radioman82/Allwellenreceiver/enclosure/radio_enclosure.stl

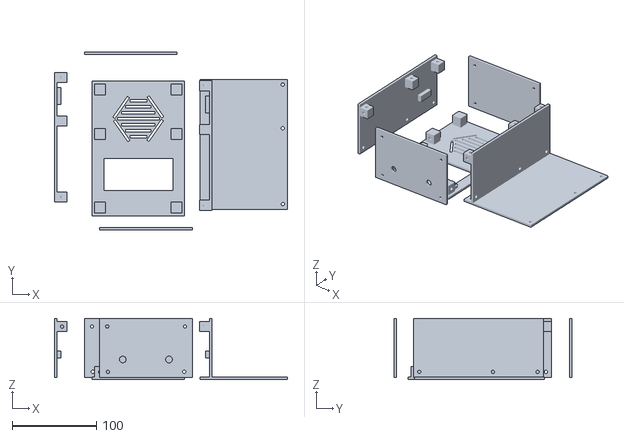
[picture p5: CAD file, 2026-10-18]
enclosure/radio_enclosure.stl
276.5 x 211.5 x 72.9
