radioman82/Allwellenreceiver/(commit log)

2026-10-18 Initial commit: Allwellenreceiver sketch, LCD 20x4, Rotary encoder, docs and license
2026-10-18 Add 3D printed enclosure STL, project photos and updated README
    [radio_enclosure.stl]
2026-10-18 Update README with battery power supply details, audio amp and user controls table
2026-10-18 Specify TDA2030 audio amplifier board in README
2026-10-18 Update README with exact 2S Li-Ion power circuit, step-down, 7805 and switched volume pot
2026-10-18 Highlight modular pin header mounting for SI4732 tuner and 20x4 LCD
